Rui6filipe/Electrocardiogram-/README.md

# Electrocardiogram

Project for Electronics Class. Done using operational amplifiers, filters and Driven Right Leg circuit

IMG_1325 (1)

Teacher's heart beating:
