Rui6filipe/Electrocardiogram-/Report.pdf

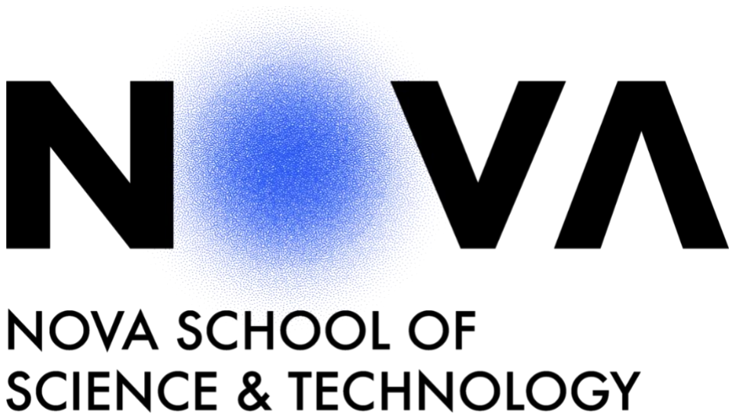
[picture p1: figure]

### Departamento de Engenharia Eletrotécnica

### e de Computadores

### Eletrónica

### Amplificador de Instrumentação baseado em Amplificadores Operacionais

Daniel Galhano, 59752, MIEF

Daniela Marques, 59939, MIEF

Gonçalo Marujo, 60101, MIEF

Rui Filipe, 60461, MIEF

2º Semestre do Ano Letivo 2021/2022

## Índice

II. Desenvolvimento da Parte Teórica – Implementação do Circuito em LT-Spice 4

### 4. Implementação do Equivalente Elétrico do Corpo Humano para Aquisição

I. Introdução

No âmbito da unidade curricular de Eletrónica, pretendemos desenvolver um amplificador de instrumentação, baseado em amplificadores operacionais, sem/com implementação do Driven Right Leg, para aplicação em sinal biomédico, mais concretamente em sinal cardíaco.
À medida que mais componentes são adicionados, poderemos verificar um aumento progressivo da complexidade do circuito, o que possibilita a consolidação de conceitos abordados nas aulas teóricas, bem como, a sua verificação, através de simulação e montagem experimental.

II. Desenvolvimento da Parte Teórica – Implementação do Circuito em LT-Spice

### 1. Implementação do Amplificador de Instrumentação

Com recurso a amplificadores operacionais LT1028A, começámos por implementar um amplificador de instrumentação (GAI = 7 V/V), seguido de um amplificador com montagem inversora (G = 100 V/V), considerando que a resistência de entrada, em cada amplificador operacional, é infinita.

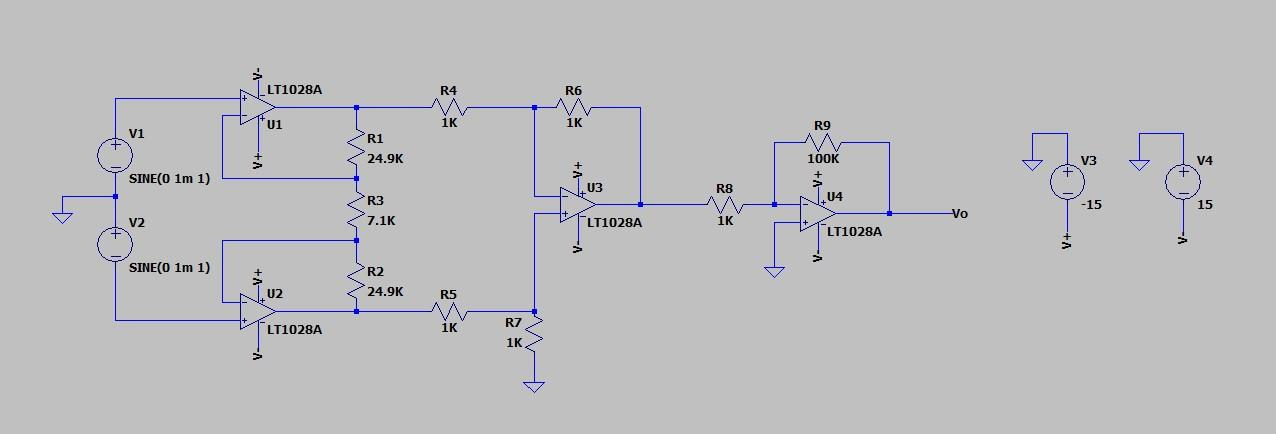
[picture p2: figure]

Tendo em consideração que R4 = R5 = R6 = R7 = 1 kΩ, obtemos um diferenciador de tensão (GD = −1 V/V). Como R1 = R2 = 24.9 kΩ e R3 = 7.1 kΩ, o ganho do amplificador de instrumentação é dado por:

GAI =

v0
v2 − v1

⇔ GAI = 1 +

2R1
R3

⇔ GAI = 1 +

2 × 24.9 kΩ
7.1 kΩ ⇔ GAI = 7 V/V

(Primeiro, definimos R1 = R2 = 24.9 kΩ porque este é o valor mais usado em amplificadores de instrumentação, sendo R3 definido consoante o ganho desejado.)

Para além disso, como R9 = 100 kΩ e R8 = 1 kΩ, o ganho do amplificador com montagem inversora é dado por:

G = −

R9
R8

⇔ G = −

100 kΩ
1 kΩ ⇔ G = −100 V/V

Por fim, é fundamental referir que a tensão fornecida aos amplificadores operacionais (neste caso, LT1028A) deve ser superior à tensão do sinal à saída que, como poderemos observar numa fase posterior, corresponderá sempre a um valor inferior a 2 V. Assim, escolhemos fornecer uma tensão de 15 V. Na fase posterior de implementação física do circuito, utilizaremos uma bateria de 9 V, que também satisfaz esta condição.

### 2. Testes ao Amplificador

Para verificar que a implementação do circuito anteriormente representado foi efetuada corretamente, testámos o seu funcionamento, através da utilização de duas fontes de tensão, com amplitude de 1 mV e frequência de 1 Hz.

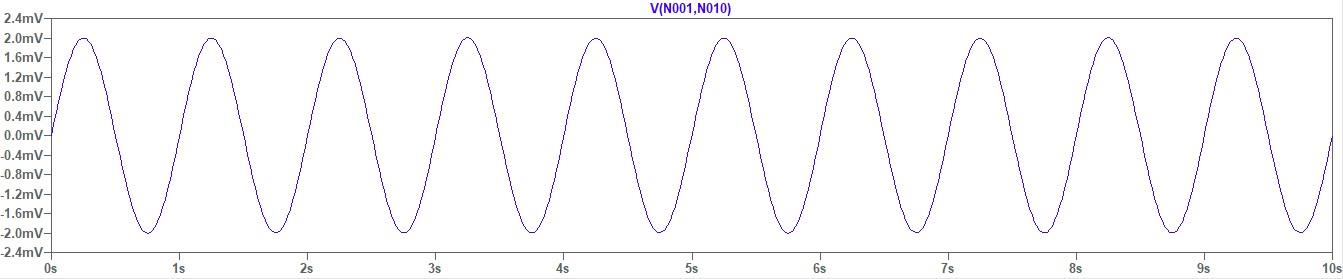
[picture p3: figure]
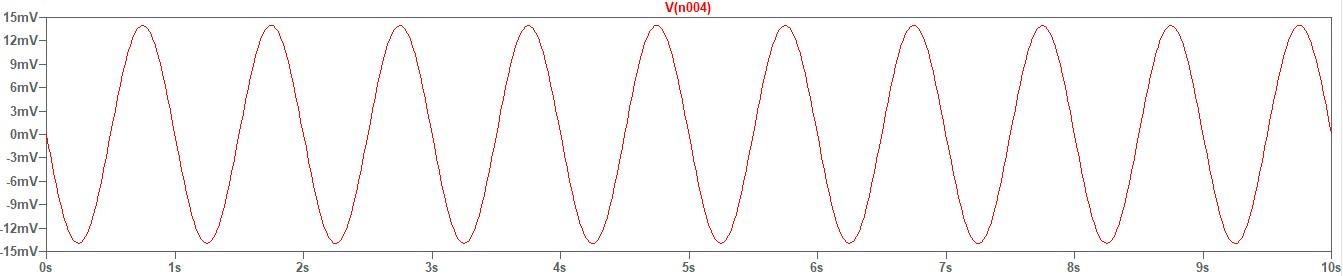
[picture p4: figure]

Na primeira simulação, podemos observar que a diferença de potencial entre v1 e v2 apresenta um valor máximo de 2 mV.

Após percorrer o amplificador de instrumentação, a diferença de potencial entre v1 e v2 é amplificada 7 vezes, de acordo com a segunda simulação.

Por conseguinte, podemos verificar que a implementação do amplificador de instrumentação foi efetuada corretamente, uma vez que:

GAI = −

14 mV
2 mV

⇔ GAI = −7 V/V

Através de uma terceira simulação, devemos analisar a diferença de potencial entre v1 e v2, no output do circuito anteriormente representado:

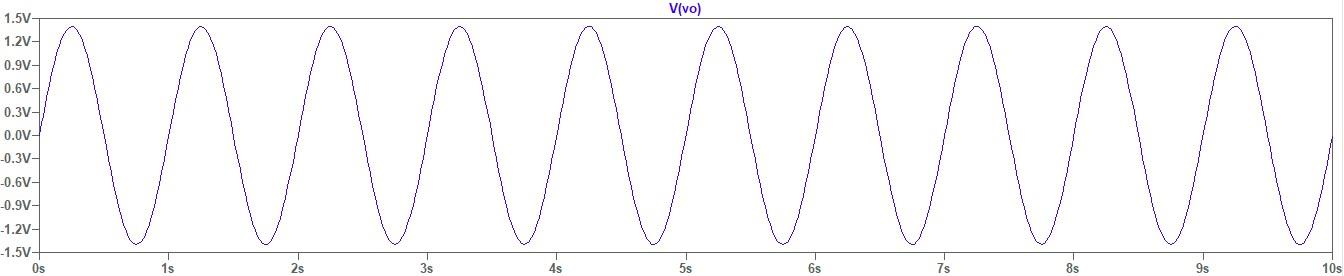
[picture p5: figure]

Verificamos então que a implementação do amplificador com montagem inversora também foi efetuada corretamente, uma vez que:

G = −

1.4 V
14 mV

⇔ G = −100 V/V

Deste modo, o ganho do circuito anteriormente representado é dado por GT = GAI × G = 700 V/V, em módulo, independentemente de o sinal à saída estar ou não em oposição de fase com o sinal à entrada, o que não é relevante no contexto da aplicação pretendida.

### 3. Ganho de Modo Comum

O circuito representado nas fases anteriores foi implementado sem qualquer tensão de modo comum, pelo que não se verifica ruído no sinal à saída. Contudo, é impossível obter um sinal à saída sem ruído, visto que seria necessário que R6⁄R4 = R7⁄R5 e não é possível obter, na prática, este nível de exatidão para as resistências utilizadas. Por isso, voltámos a implementar o circuito, de modo a obtermos um ganho de modo comum de 0.1 V/V, no amplificador de instrumentação.

Retirámos as fontes de tensão v1 e v2 - de modo a ser percetível a comparação entre o circuito com e sem ganho de modo comum - e acrescentámos uma tensão de modo comum, vCM, de amplitude igual a 1 mV. Alterámos o valor da resistência R6 para 800 Ω, mantendo R4 = R5 = R7 = 1 kΩ, de acordo com a expressão que permite calcular o ganho de modo comum:

ACM = −

R6
R4

+ (1 +

R6
R4

)

R7
R5 + R7

⇔ 0.1 = −R6 +

1 + R6
2

⇔ R6 = 0.8kΩ

Uma vez que foram modificadas as resistências associadas ao amplificador diferencial dentro do amplificador de instrumentação, este passa a ter um ganho total dado pela expressão:

GAI =

R6
R4

(1 +

2R3
R1

) ⇔ GAI = 0.8 × 7 = 5.6 V/V

De modo a manter este ganho a 7 V/V, modificámos R1 de modo que:

GAI = 7 ⇔ 0.8 (1 +

2 × 24.9
R1

) = 7 ⇔ R1 = 6.43kΩ

Obtivemos então o seguinte circuito, e confirmámos depois estes resultados através de simulações:

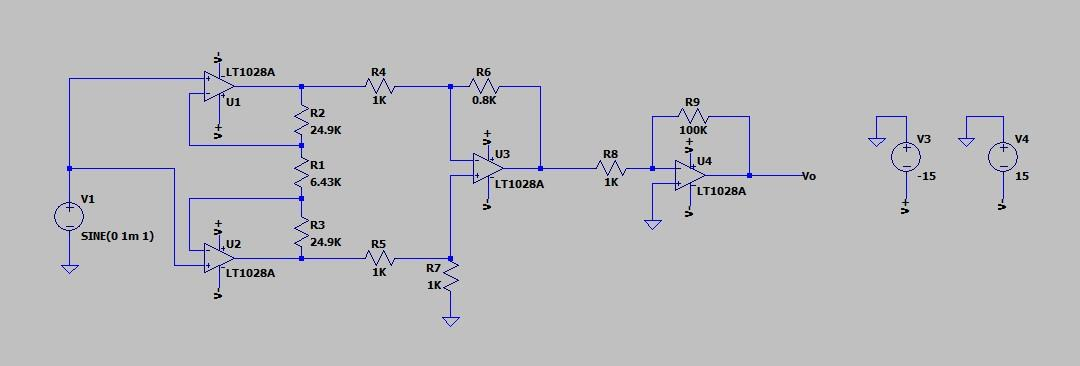
[picture p6: figure]
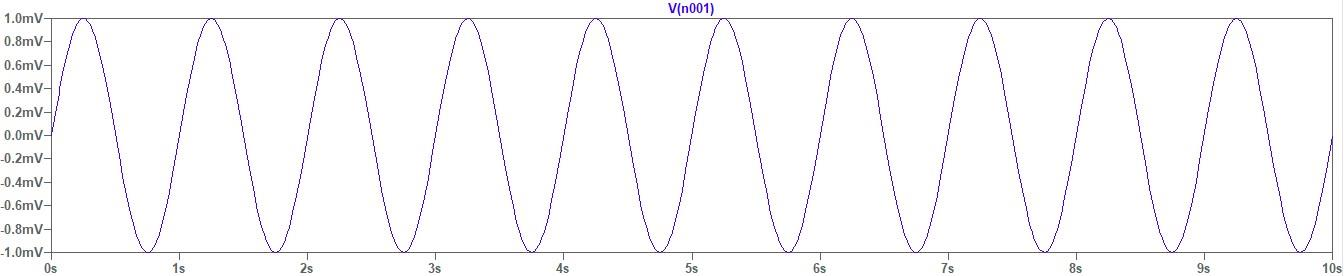
[picture p7: figure]
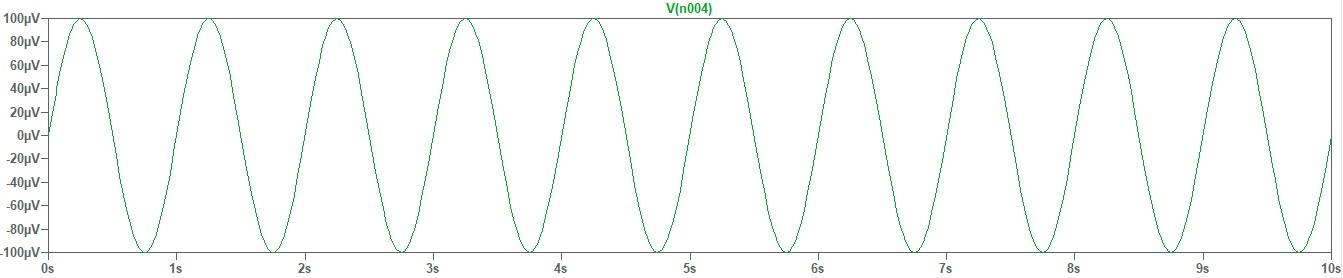
[picture p8: figure]

No primeiro gráfico, podemos observar que a tensão de modo comum apresenta um valor máximo de 1 mV.

Após percorrer o amplificador de instrumentação, a tensão de modo comum é amplificada 0.1 vezes (Gi =

100 μV
1 mV

= 0.1 V/V), de acordo com o segundo

gráfico.

### 4. Implementação do Equivalente Elétrico do Corpo Humano

para Aquisição do Eletrocardiograma

De modo a efetuar a implementação do equivalente elétrico do corpo humano, para aquisição do eletrocardiograma, recorremos a uma fonte de tensão, com amplitude de 2 mV e frequência de 50 Hz. Para além disso, considerámos que a resistência elétrodo-pele corresponde a 50 kΩ, nos três terminais de ligação à pele.

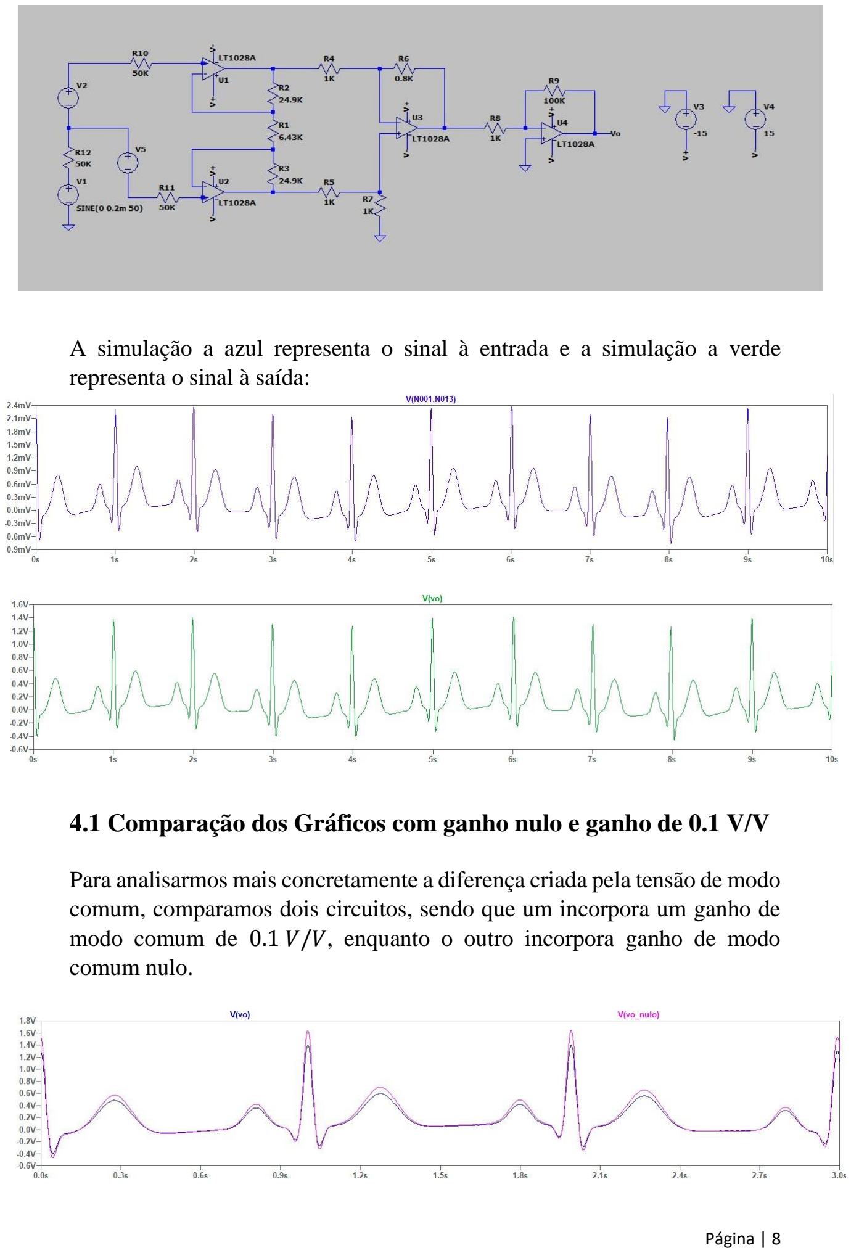
[picture p9: page 8]

A simulação a azul representa o sinal à entrada e a simulação a verde representa o sinal à saída:

### 4.1 Comparação dos Gráficos com ganho nulo e ganho de 0.1 V/V

Para analisarmos mais concretamente a diferença criada pela tensão de modo comum, comparamos dois circuitos, sendo que um incorpora um ganho de modo comum de 0.1 V/V, enquanto o outro incorpora ganho de modo comum nulo.

Na simulação anteriormente apresentada, podemos observar o sinal de saída do circuito com ganho de modo comum de 0.1 V/V (azul) e do circuito com ganho de modo comum nulo (rosa), em ordem ao tempo. Enquanto o gráfico rosa mantém intacta a forma do sinal de entrada, podemos observar que o gráfico azul fornece uma forma semelhante, mas somado com uma onda sinusoidal, que tem origem na tensão de modo comum com frequência de 50 Hz, representando o ruído do sinal.

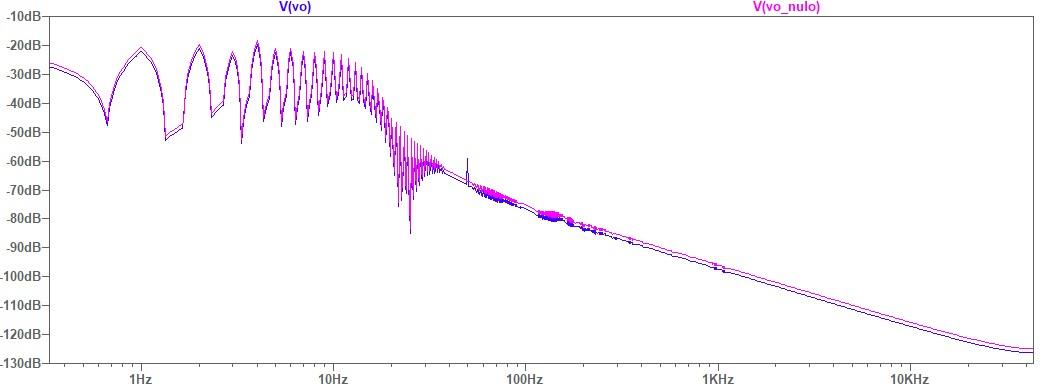
[picture p10: figure]

Através da Transformada Rápida de Fourier (FFT), podemos analisar as frequências que constituem o sinal, sendo que, no circuito com ganho de modo comum não-nulo, encontramos um pico nos 50 Hertz, revelando o efeito da tensão de modo comum no sinal.

### 4.2 Presença da Tensão de Modo Comum à Saída

Na Transformada Rápida de Fourier (FFT), a diferença causada pela tensão de modo comum no sinal à saída do circuito é evidente a partir de uma amplitude de 0.1 mV. No entanto, no gráfico temporal, o ruído só se começa a notar no sinal de saída a partir de uma tensão de modo comum de 1 mV.

Para chegar a esta conclusão, analisámos os gráficos para vários valores entre 0.01 mV e 1 mV. Seguem-se os gráficos temporais e FFTs correspondentes às tensões de 0.01 mV e 1 mV:

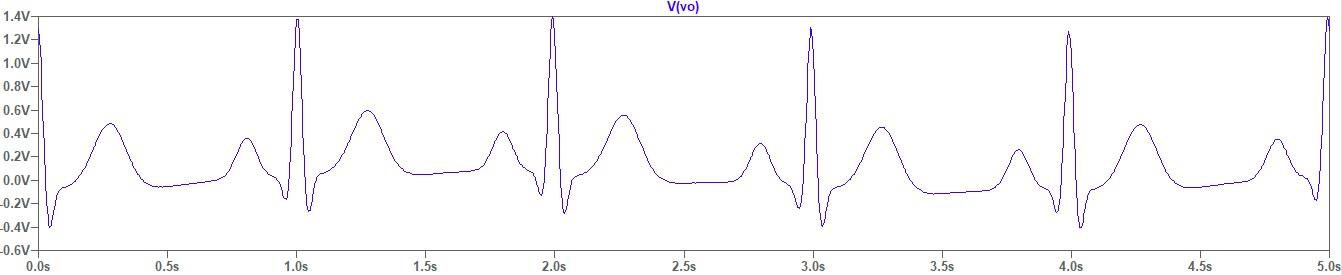
[picture p11: figure]

-Gráfico Temporal para 0.1mV

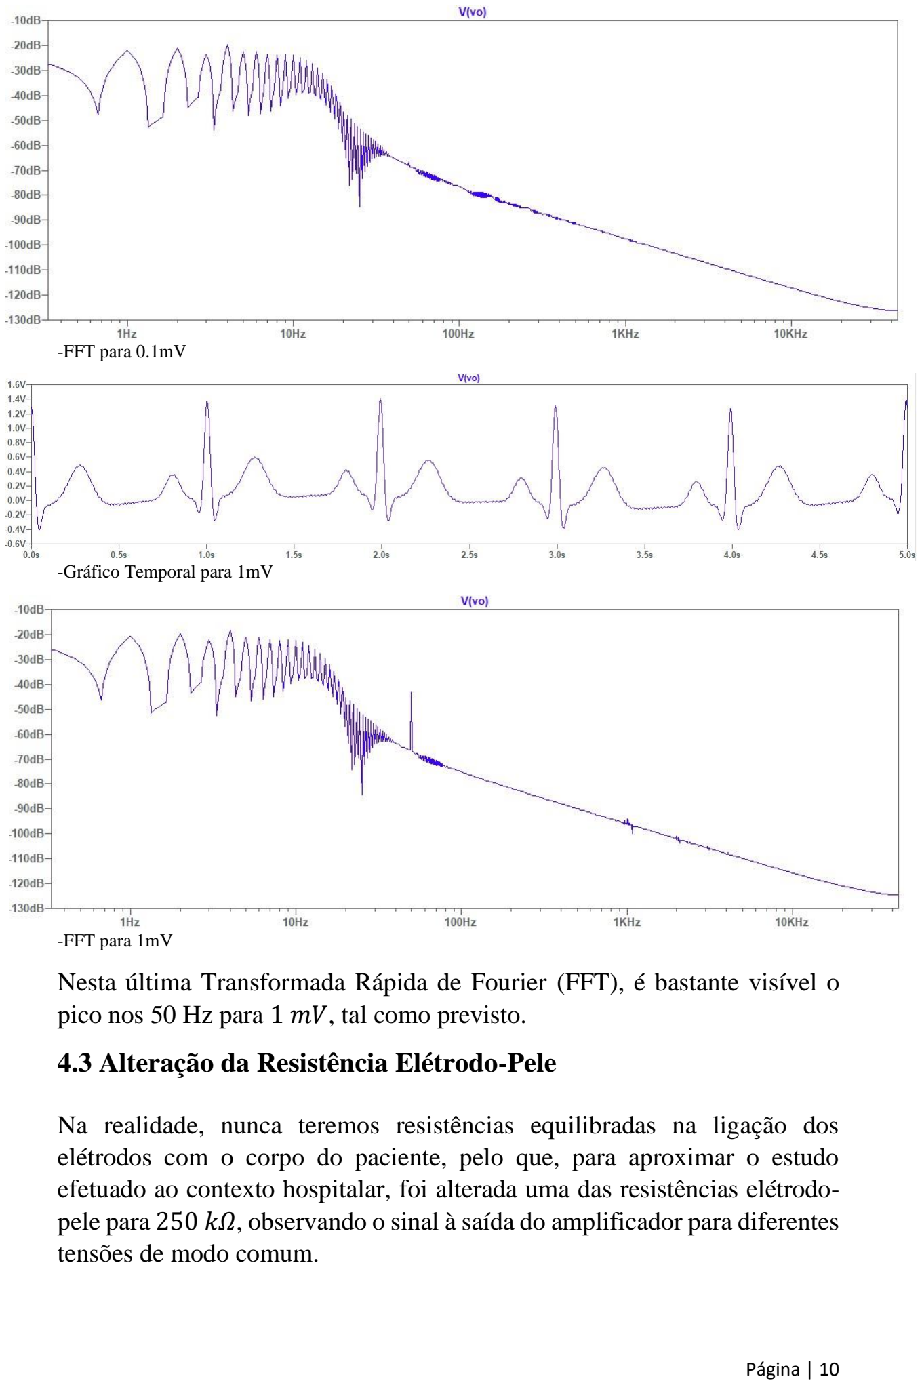
[picture p12: page 10]

-FFT para 0.1mV

-Gráfico Temporal para 1mV

-FFT para 1mV
Nesta última Transformada Rápida de Fourier (FFT), é bastante visível o pico nos 50 Hz para 1 mV, tal como previsto.

### 4.3 Alteração da Resistência Elétrodo-Pele

Na realidade, nunca teremos resistências equilibradas na ligação dos elétrodos com o corpo do paciente, pelo que, para aproximar o estudo efetuado ao contexto hospitalar, foi alterada uma das resistências elétrodo-pele para 250 kΩ, observando o sinal à saída do amplificador para diferentes tensões de modo comum.

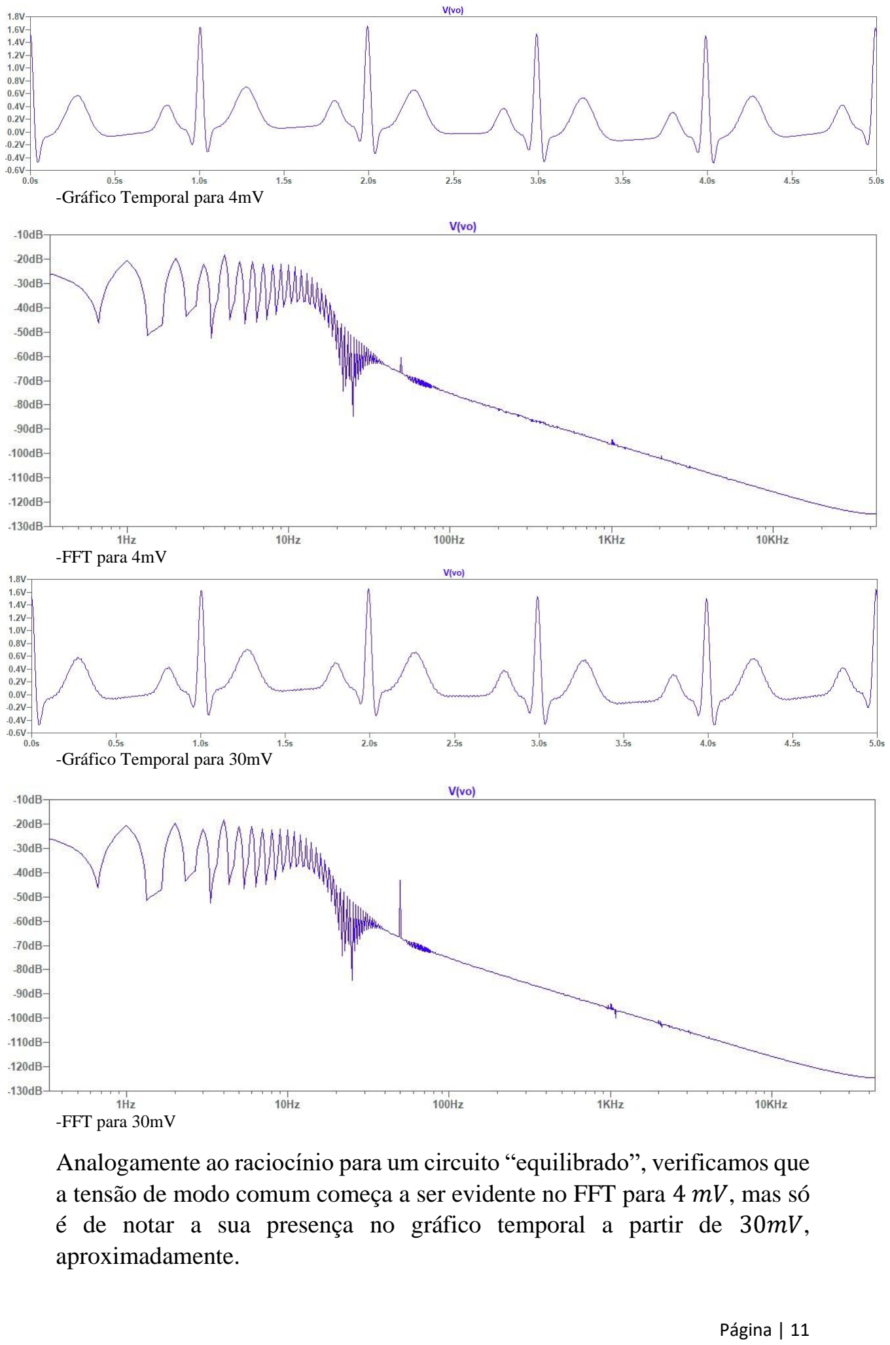
[picture p13: page 11]

-Gráfico Temporal para 4mV

-FFT para 4mV

-Gráfico Temporal para 30mV

-FFT para 30mV
Analogamente ao raciocínio para um circuito “equilibrado”, verificamos que a tensão de modo comum começa a ser evidente no FFT para 4 mV, mas só é de notar a sua presença no gráfico temporal a partir de 30mV, aproximadamente.

Concluímos ainda que, quando o ganho de modo comum do amplificador diferencial é nulo, mas a resistência elétrica elétrodo-pele de um dos elétrodos do tórax aumenta para um valor de 250kΩ (circuito desequilibrado), o ganho de modo comum do amplificador de instrumentação aumenta, deixando de ser igual a zero.

### 5. Implementação do Driven Right Leg (DRL)

A implementação da componente Driven Right Leg (DRL) permite inserir no circuito uma tensão que anule ao máximo possível a tensão de modo comum vCM, atenuando o ruído da fonte de tensão de 50 Hz, no circuito estudado anteriormente. Nesta fase, pretende-se ainda proteger o paciente em caso de curto-circuito, pelo que adicionámos a resistência R15 = 1 MΩ.

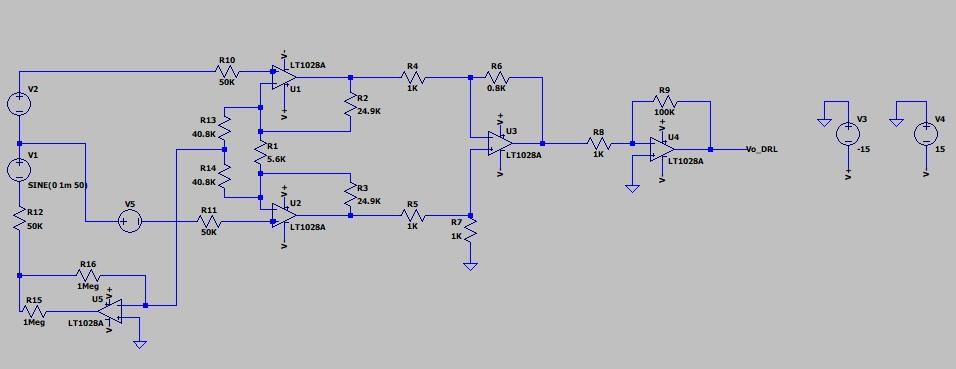
[picture p14: figure]

### 5.1 Tensão no Elétrodo da Perna

Para estudar a tensão na perna do paciente, considerámos uma corrente de fuga de id = 1 µA e uma resistência elétrodo-pele de RRL = 50 kΩ. Sem implementação do Driven Right Leg (DRL), a tensão no elétrodo da perna é dada por:

vcmsem DRL = RRL × id ⇔ vcm = 50 kΩ × 1 µA ⇔ vcm = 50 mV

A tensão no elétrodo da perna sem implementação de DRL deverá ser aquela que anulará a tensão de modo comum à entrada do circuito – considerámos o valor de tensão de modo comum a partir do qual se nota a sua presença à saída do circuito no gráfico temporal (1 mV – que corresponde ao valor encontrado no tópico 5.2 Presença de tensão de modo comum à saída):

vcmcom DRL = 1mV

Explicação de Resistências Utilizadas:

Este objetivo para valor de tensão à saída do amplificador DRL de 1 mV é o que nos permitirá chegar ao valor da resistência Ra = R13 = R14, aplicando a seguinte expressão:

vcm =

RRL × id

1 +

2Rf
Ra

⇔ Ra =

2Rf

RRL × id
vcm

− 1

Fazendo Rf = R16 = 1 MΩ e vcm = 1 mV, determinamos Ra = 40.8 kΩ.

Passemos a explicar a mudança do valor da resistência R1: reparámos que adicionar as resistências R13 e R14 faz com que o valor do ganho do amplificador de instrumentação seja alterado. Não existindo uma fórmula teórica de modo a determinar a resistência R1 para reajustar este ganho, determinámo-lo experimentalmente. Uma vez que o ganho pretendido é o inicial (7 V/V) e o sinal de entrada tem um valor de tensão máximo de 2,4mV, o nosso objetivo é que o valor máximo de tensão do sinal de saída do circuito seja 2,4 × 700 = 1,68V. Assim, através de tentativa e erro, obtivemos R1 = 5.6 kΩ.

### 5.2 Ganho selecionado para o Amplificador DRL

A fórmula que permite calcular o ganho teórico do amplificador DRL é:

G =

vDRL

vCM

= −

2R16
R13

= −

2 × 1M
40.8k

= −49 V/V

Pela análise de gráficos temporais, podemos verificar qual a tensão de modo comum à entrada do circuito (vCM) e qual o valor de tensão que “entra” de novo no circuito após a passagem pelo amplificador DRL (vDRL), de modo a confirmar este ganho. Para tal, retirámos do circuito as fontes de ECG, deixando apenas a fonte de tensão de modo comum, de modo a termos uma leitura facilitada.

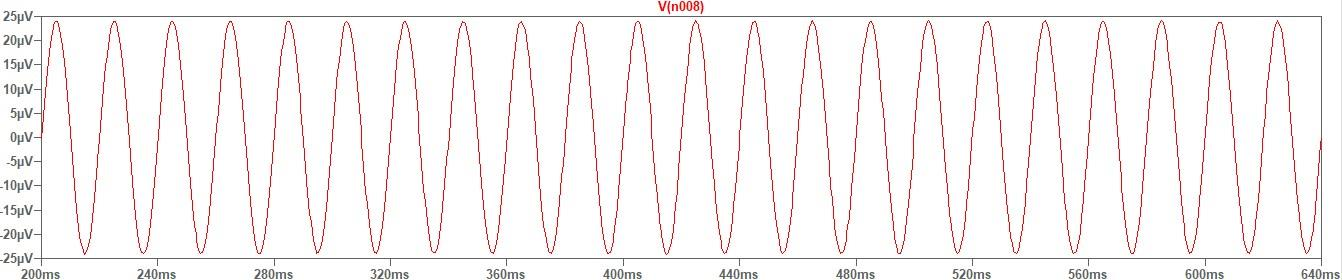
[picture p15: figure]

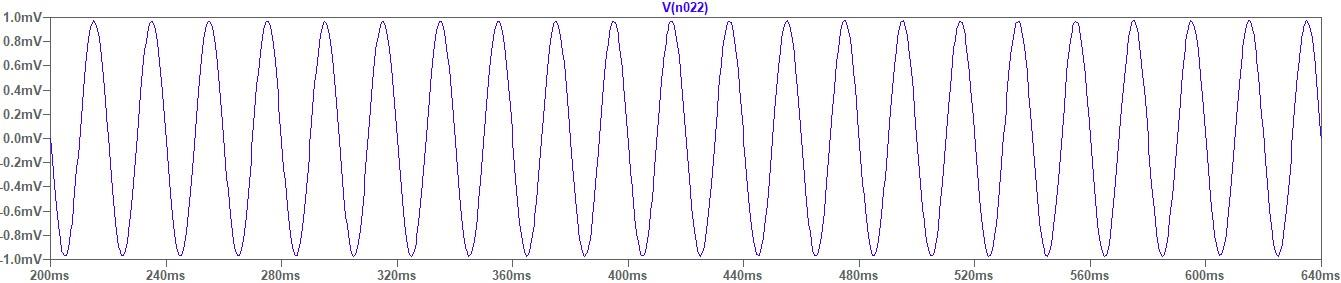
[picture p16: figure]

No gráfico a vermelho temos a tensão vCM, com uma amplitude de 24 μV. No gráfico a azul temos a tensão à saída do amplificador DRL com uma amplitude de aproximadamente 1 mV (como esperado). Como podemos observar, os sinais representados apresentam-se em oposição de fase. Com isto, obtemos um valor semelhante ao teoricamente previsto:

G = −

vDRL

vCM

= −

1mV
24μV

= −42 V/V

### 5.3 Vantagens da Técnica DRL

Esta técnica tem como objetivo a redução do ruído criado pela tensão do modo comum, tal como a proteção do paciente. Para observarmos esse resultado, utilizámos o circuito com um ganho de modo comum de 0.1 V/V, tensão de modo comum de 1 mV e uma resistência elétrodo-pele de 250 kΩ.

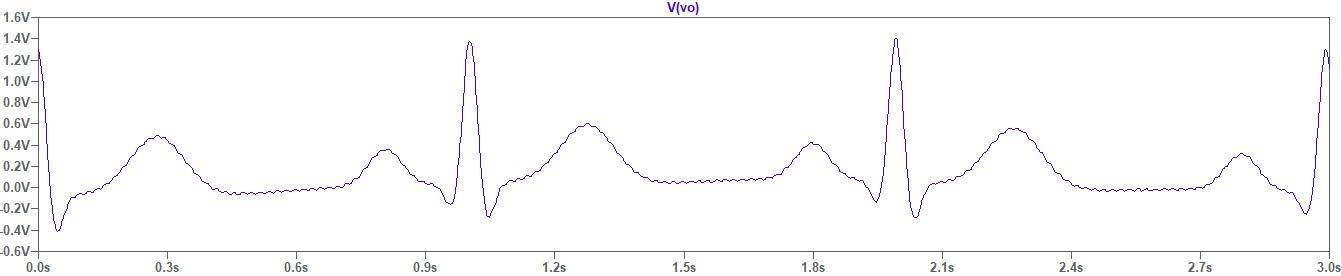
[picture p17: figure]

-Gráfico Temporal sem DRL

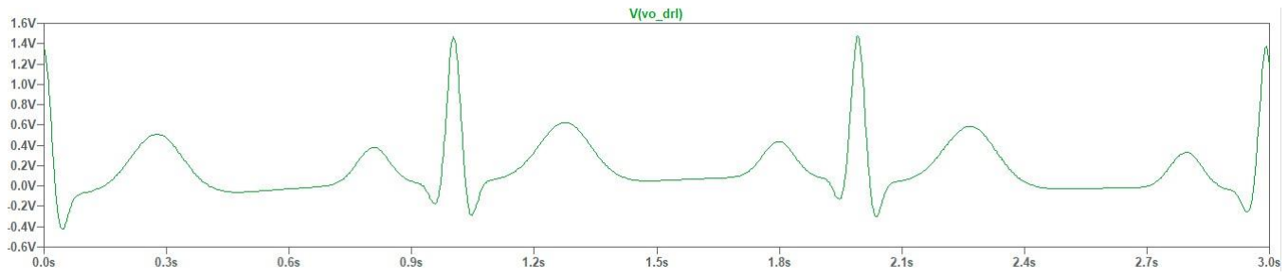
[picture p18: figure]

-Gráfico Temporal com DRL

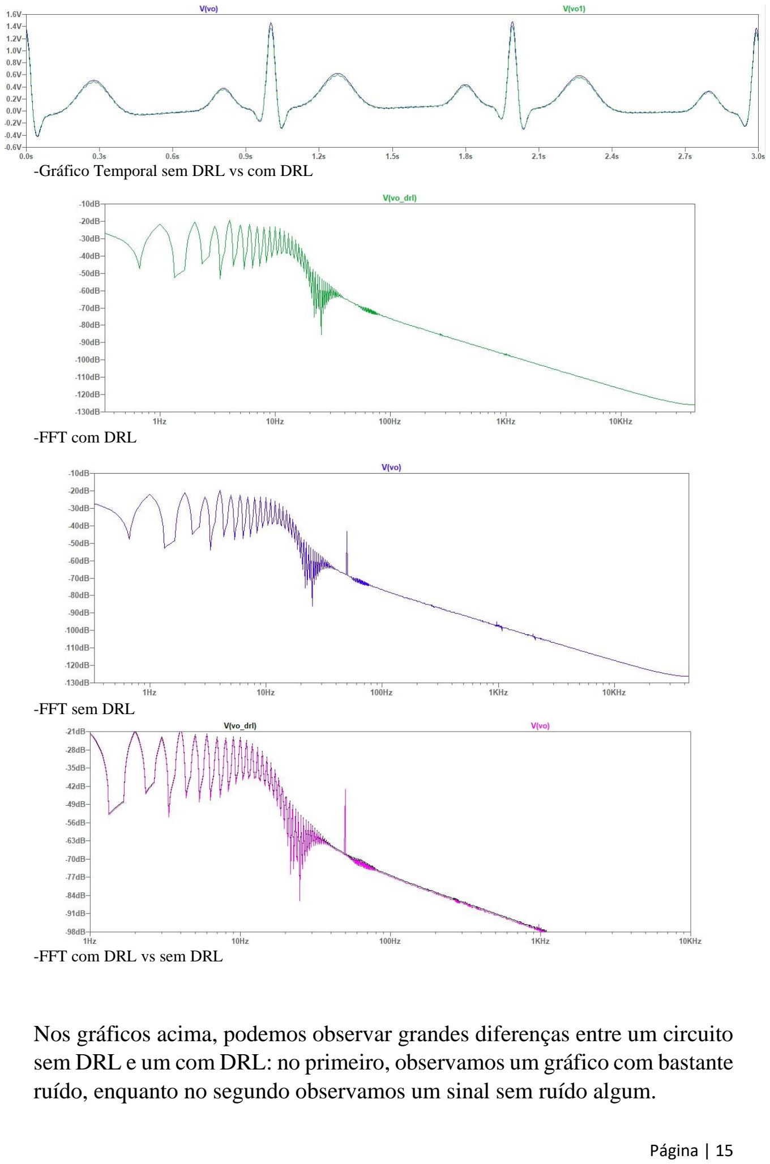
[picture p19: page 15]

-Gráfico Temporal sem DRL vs com DRL

-FFT com DRL

-FFT sem DRL

-FFT com DRL vs sem DRL

Nos gráficos acima, podemos observar grandes diferenças entre um circuito sem DRL e um com DRL: no primeiro, observamos um gráfico com bastante ruído, enquanto no segundo observamos um sinal sem ruído algum.

No gráfico FFT para circuito sem DRL, podemos observar um pico na casa dos 50 Hz. Por outro lado, quando observamos o gráfico FFT na presença de DRL, notamos que este pico desaparece.

### 5.4 Corrente Máxima injetada no Paciente

Verifiquemos, agora, se a montagem é prejudicial para o paciente. Para isso, é necessário medir a corrente no elétrodo-pele de 50 kΩ que se encontra antes da fonte de tensão de modo comum.

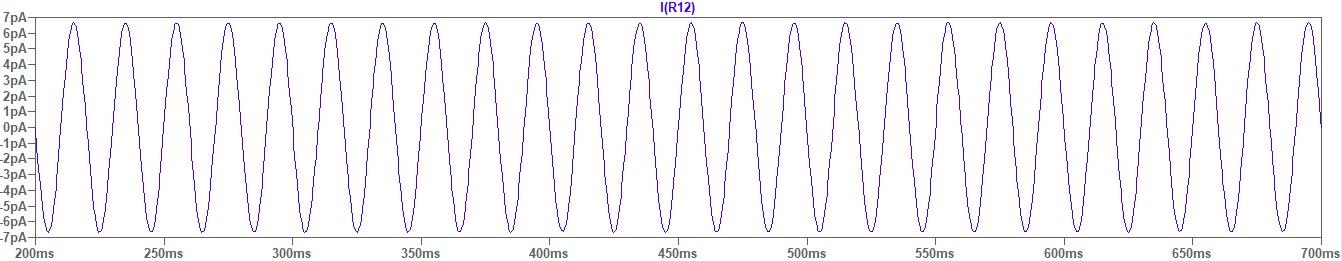
[picture p20: figure]

-Corrente máxima com DRL

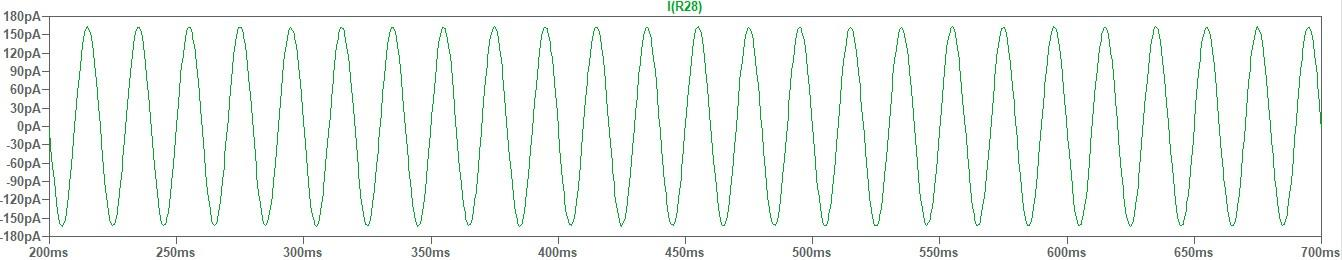
[picture p21: figure]

-Corrente máxima sem DRL

Na presença do DRL, observamos uma amplitude de para a corrente de 6,8 pA; sem a presença do DRL observamos uma amplitude de 165 pA.

Apesar de nenhum destes valores de corrente ser prejudicial para o paciente, conclui-se que existe uma diminuição considerável de corrente (diminuição em 96%) aquando da utilização do DRL relativamente ao circuito sem DRL.

### 6. Filtro de Banda Passante de 1 a 70 Hz

Com o objetivo de atenuar fortemente as frequências inferiores a 1Hz e superiores a 70 Hz, implementámos um filtro de banda passante, com recurso a filtros passivos. Para esse efeito, utilizámos um filtro low-pass, a seguir ao último amplificador, para uma frequência limite de 70 Hz, e um filtro high-pass, para uma frequência limite de 1Hz, antes do mesmo.

O amplificador com G = 100 V/V deve estar na montagem inversora, de modo a implementar o filtro de banda passante sem ocorrerem alterações no seu ganho. Por conseguinte, para o sinal à saída não estar em oposição de fase com o sinal à entrada, implementámos um seguidor de tensão na montagem inversora, apresentando GST = −1, imediatamente antes da aplicação dos filtros.

Os valores dos condensadores e resistências foram calculados a partir da seguinte expressão, onde f representa o valor da frequência limite:

f =

1
2πRC

Como temos duas variáveis em cada equação, escolhemos um valor para os condensadores e calculámos, através dos mesmos, os valores das resistências. Para o filtro high-pass, escolhemos C1 = 1 μF, pelo que podemos determinar R29 = 158 kΩ. Para o filtro low-pass, escolhemos C2 = 0.01 μF, pelo que podemos determinar R30 = 226 kΩ.

Assim, obtivemos o seguinte circuito:

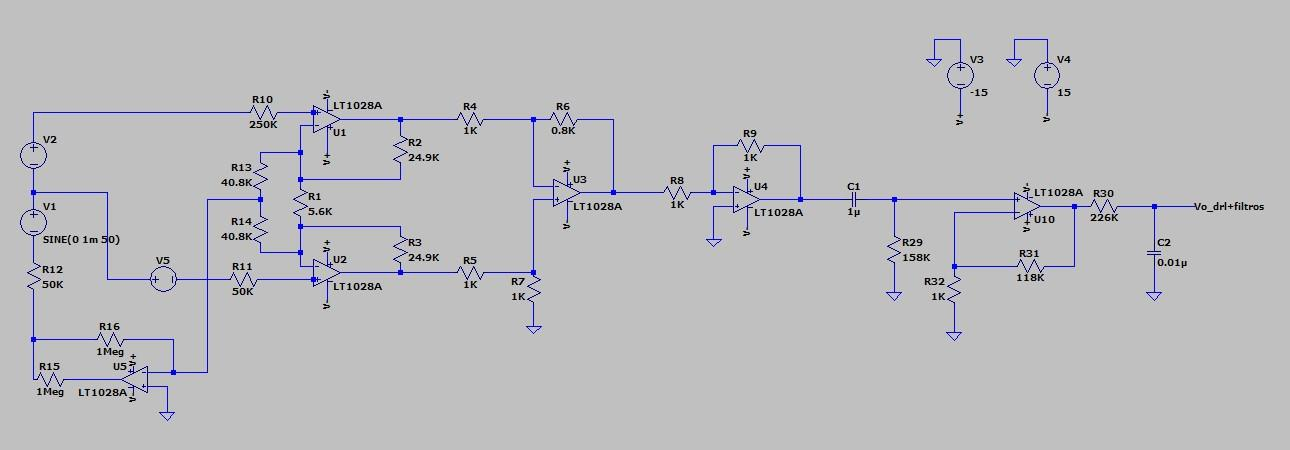
[picture p22: figure]

### 7. Adição de Ruído Branco

Por forma a ser notória a ação do filtro de banda passante, adicionámos ruído branco ao sinal de eletrocardiograma. Assim, é-nos possível comparar o sinal de saída dos circuitos implementados sem/com filtro de banda passante, tendo valores iguais aos anteriormente apresentados: com ganho de modo comum 0.1 V/V, uma das resistências elétrodo-pele a 250 kΩ e, naturalmente, com implementação do Driven Right Leg (DRL).

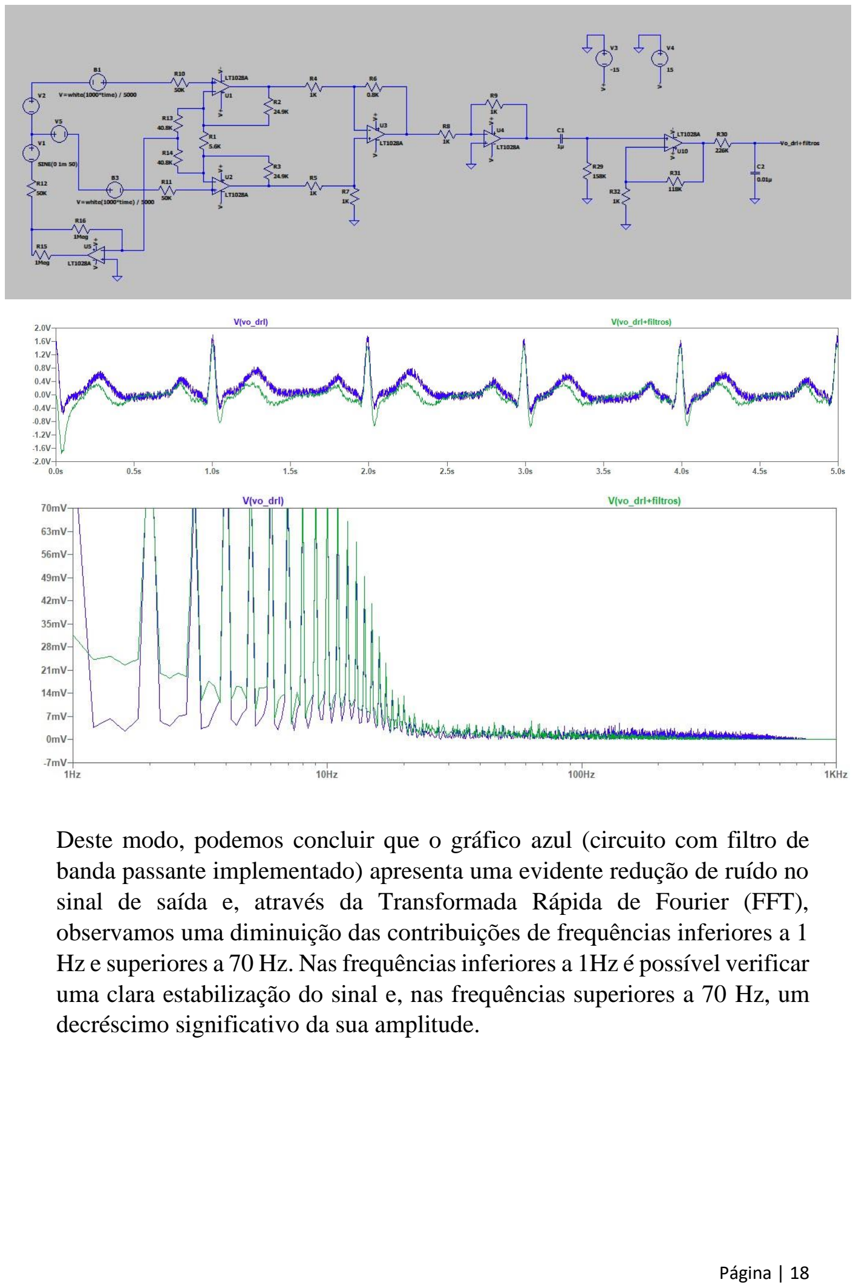
[picture p23: page 18]

Deste modo, podemos concluir que o gráfico azul (circuito com filtro de banda passante implementado) apresenta uma evidente redução de ruído no sinal de saída e, através da Transformada Rápida de Fourier (FFT), observamos uma diminuição das contribuições de frequências inferiores a 1 Hz e superiores a 70 Hz. Nas frequências inferiores a 1Hz é possível verificar uma clara estabilização do sinal e, nas frequências superiores a 70 Hz, um decréscimo significativo da sua amplitude.

III. Implementação Física na BreadBoard

Após a implementação teórica do circuito e realização de todas as simulações necessárias para confirmar o bom funcionamento do mesmo, a fase seguinte passou por implementar o circuito numa BreadBoard.

Para tal, adquirimos o material necessário: fios de ligação, baterias,
resistências, | condensadores | e | circuitos | integrados | que | contêm
amplificadores operacionais.
- Adquirimos duas baterias de 9 V: uma que servirá como fonte de alimentação negativa dos amplificadores operacionais, outra como fonte positiva.
- Uma vez que é muito difícil encontrar valores para resistências idênticos aos valores projetados, escolhemos o valor mais próximo possível para cada uma. As resistências que foram utilizadas nesta montagem são da série e24, apresentando um erro de, no máximo, 5%. A utilização destas resistências justifica-se pelo facto de o seu custo ser menor. Só foi possível comprar resistências em pacotes de cinco, com um preço de 25 cêntimos cada pacote.
- Os condensadores necessários para a montagem são do tipo cerâmico (não polarizados), uma vez que estes são os utilizados para filtros.
- Os amplificadores operacionais adquiridos e usados foram diferentes dos projetados inicialmente devido ao preço atual dos últimos. Foram comprados dois circuitos integrados com quatro amplificadores operacionais cada um, e optámos por utilizar 3 amp-ops em cada um dos circuitos integrados, de modo a organizar o circuito da melhor maneira possível.

Assim, obtivemos a seguinte montagem, já ligada ao osciloscópio e aos elétrodos que permitem ler o sinal de eletrocardiograma proveniente do paciente:

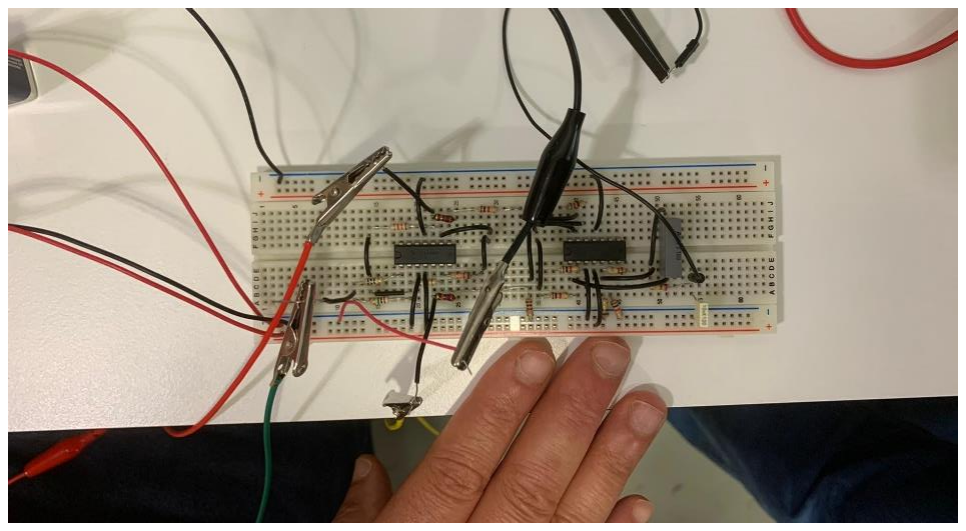
[picture p24: figure]

Por fim, no osciloscópio, foi-nos possível visualizar o sinal de eletrocardiograma com implementação de Driven Right Leg:

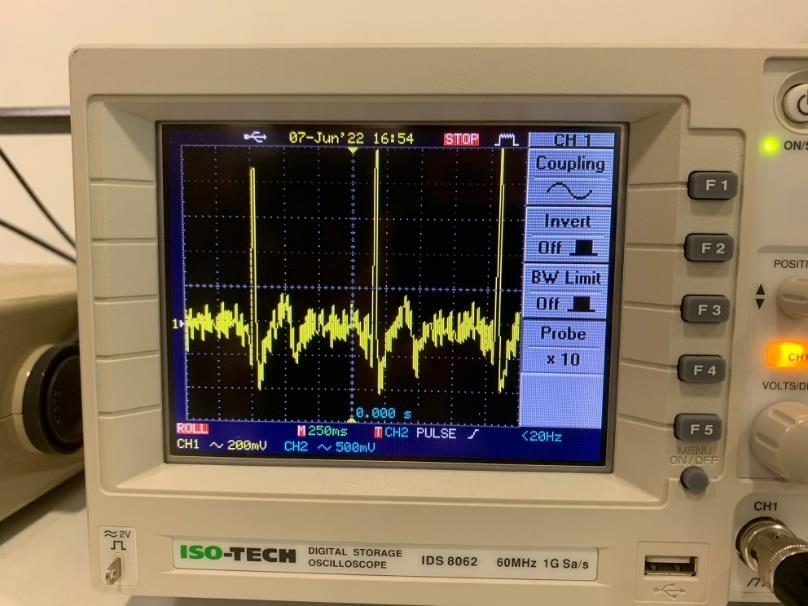
[picture p25: figure]

Inicialmente, testou-se o circuito sem DRL, tendo sido visualizado um sinal com bastante ruído. Ao implementar o DRL no circuito, notou-se uma diminuição considerável no mesmo, apesar de ainda estar presente algum ruído no sinal visualizado na imagem acima.

Uma vez que a escala do osciloscópio, na imagem, se encontra nos 200 mV por divisão vertical, e o sinal ocupa aproximadamente 7 casas na vertical, conclui-se que a tensão do sinal se enquadra na ordem prevista, de acordo com o ganho que era esperado do amplificador.

Pequenos desvios encontrados relativamente ao ganho do amplificador e ao ruído, comparativamente com as simulações anteriores, devem-se a:

- Os valores de resistências ligadas aos amplificadores operacionais serem ligeiramente diferentes do circuito projetado;
- O sinal de ruído poder ter tensão superior a 1 mV, que foi o valor utilizado nas simulações;
- As resistências elétrodo-pele reais serem diferentes das que se idealizaram para obter o equivalente do corpo humano.

IV. Conclusão

Através da realização deste projeto, tivemos oportunidade de expandir o nosso conhecimento, bem como desenvolver competências ao entrar em contacto com a dimensão prática e experimental de Eletrónica, o que só foi possível devido à aplicação de conhecimentos teóricos adquiridos ao longo do semestre. Ao longo de toda a extensão do projeto, os cálculos foram efetuados, assumindo que os componentes implementados são ideais. No entanto, o LTSpice permite a utilização de componentes eletrónicos com características muito próximas da realidade. Para além disso, foi necessário algum sentido crítico por parte do grupo, de modo a entender se os resultados obtidos correspondiam ao teoricamente previsto.

Implementámos, de início ao fim, um circuito que permite amplificar o sinal de um eletrocardiograma, através de amplificadores operacionais. São vários os aspetos importantes na implementação de um circuito desta natureza, visto que o mais pequeno detalhe pode provocar a obtenção de resultados incorretos. Como tal, foi necessário investigar a fundo e questionar sempre os resultados obtidos.

V. Bibliografia
1. Conjunto de slides e material de estudo disponibilizados pelos docentes
2. Alguns websites:
- https://electronics.stackexchange.com/questions/595051/how-does-a-driven-right-leg-work (https://electronics.stackexchange.com/questions/595051/how-does-a-driven-right-leg-work)
