Rui6filipe/Electrocardiogram-/SpiceSchematic.asc

B1: bv; V=white(1000*time) / 5000
B2: bv; V=white(1000*time) / 5000
B3: bv; V=white(1000*time) / 5000
B4: bv; V= white(1000*time) / 5000
C1: cap; 1ľ; V=6.3 Irms=0 Rser=0 Lser=0 mfg="Murata" pn="GRM155R70J105MA12" type="X7R"
C2: cap; 0.01ľ; V=4 Irms=162m Rser=0.395426 Lser=0 mfg="KEMET" pn="C0402C103K7PAC" type="X5R"
R1: res; 5.6K; tol=1 pwr=0.1
R2: res; 24.9K; tol=1 pwr=0.1
R3: res; 24.9K; tol=1 pwr=0.1
R4: res; 1K
R5: res; 1K
R6: res; 0.8K
R7: res; 1K
R8: res; 1K; tol=1 pwr=0.1
R9: res; 1K; tol=1 pwr=0.1
R10: res; 50K; tol=1 pwr=0.1
R11: res; 50K; tol=1 pwr=0.1
R12: res; 50K
R13: res; 40.8K; tol=1 pwr=0.1
R14: res; 40.8K; tol=1 pwr=0.1
R15: res; 1Meg
R16: res; 1Meg; tol=1 pwr=0.1
R17: res; 24.9K
R18: res; 24.9K
R19: res; 5.6K
R20: res; 1K
R21: res; 1K
R22: res; 806; tol=1 pwr=0.1
R23: res; 1K
R24: res; 1K; tol=1 pwr=0.1
R25: res; 100K; tol=1 pwr=0.1
R26: res; 50K; tol=1 pwr=0.1
R27: res; 50K; tol=1 pwr=0.1
R28: res; 50K
R29: res; 158K; tol=1 pwr=0.1
R30: res; 226K; tol=1 pwr=0.1
R31: res; 118K; tol=1 pwr=0.1
R32: res; 1K; tol=1 pwr=0.1
R33: res; 40.8K; tol=1 pwr=0.1
R34: res; 40.8K; tol=1 pwr=0.1
R35: res; 1Meg
R36: res; 1Meg; tol=1 pwr=0.1
U1: LT1028A
U2: LT1028A
U3: LT1028A
U4: LT1028A
U5: LT1028A
U6: LT1028A
U7: LT1028A
U8: LT1028A
U9: LT1028A
U10: LT1028A
U11: LT1028A
V1: voltage; SINE(0 1m 50)
V2: voltage; PWL file=ecg_new.txt
V3: voltage; -15
V4: voltage; 15
V5: voltage; PWL file=ecg_new.txt
V8: voltage; SINE(0 1m 50)
V9: voltage; PWL file=ecg_new.txt
V10: voltage; PWL file=ecg_new.txt
Named nets: 0, V+, V-, Vo_drl, Vo_drl+filtros
.tran 5s
