Rui6filipe/Electrocardiogram-/TestFile.txt

   0.0000000e+00   1.0847010e-03
   9.7656250e-04   1.0808847e-03
   1.9531250e-03   1.0723737e-03
   2.9296875e-03   1.0592360e-03
   3.9062500e-03   1.0415842e-03
   4.8828125e-03   1.0195736e-03
   5.8593750e-03   9.9330027e-04
   6.8359375e-03   9.6292620e-04
   7.8125000e-03   9.2884044e-04
   8.7890625e-03   8.9142589e-04
   9.7656250e-03   8.5105678e-04
   1.0742188e-02   8.0809863e-04
   1.1718750e-02   7.6290830e-04
   1.2695312e-02   7.1583397e-04
   1.3671875e-02   6.6721511e-04
   1.4648438e-02   6.1738255e-04
   1.5625000e-02   5.6665840e-04
   1.6601562e-02   5.1535611e-04
   1.7578125e-02   4.6378044e-04
   1.8554688e-02   4.1222748e-04
   1.9531250e-02   3.6098462e-04
   2.0507812e-02   3.1033057e-04
   2.1484375e-02   2.6053538e-04
   2.2460938e-02   2.1186039e-04
   2.3437500e-02   1.6455827e-04
   2.4414062e-02   1.1887302e-04
   2.5390625e-02   7.5035932e-05
   2.6367188e-02   3.3183095e-05
   2.7343750e-02  -6.6100106e-06
   2.8320312e-02  -4.4273285e-05
   2.9296875e-02  -7.9746910e-05
   3.0273438e-02  -1.1298135e-04
   3.1250000e-02  -1.4393734e-04
   3.2226562e-02  -1.7258592e-04
   3.3203125e-02  -1.9890838e-04
   3.4179688e-02  -2.2289631e-04
   3.5156250e-02  -2.4455158e-04
   3.6132812e-02  -2.6388634e-04
   3.7109375e-02  -2.8092302e-04
   3.8085938e-02  -2.9569433e-04
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
